esynr3z/kicad-lib/(commit log)

2018-08-26 Add NCP3163 with SOIC-16 footprint
2018-08-31 Add diode SMA fp
2018-09-19 Add some SMD capacitors
2018-09-19 Add MBRA340 diode
2018-09-19 Add BZX84C4V7 diode
2019-03-30 Add 1206 led fp
2019-04-02 Add pair of mosfet symbols
2019-04-05 Add some smd tact switches
2019-04-05 Add special pin header
2019-04-05 Add 3d model for 6x6 smd tact switch
2019-04-06 Fix fields in FET symbol lib
2019-10-13 Add pickle rick footprint
2019-10-13 Add m3 mounting hole footprint
2019-10-13 fix lm4871 footprint
2019-10-18 Add 3 pole solder jumper
2019-10-18 Add 2 pins connector symbol
2019-10-19 Add another solder jumper footprint
2019-10-19 Add tps54302 regulator
2019-10-21 Add several inductors footprints
2019-10-24 Update diode lib
2019-10-24 Add 0805 led
2019-10-27 Add mounting hole symbol
2019-10-27 Add screw terminal 5mm
2019-11-04 Add few pin headers
2019-11-04 Add 6 pin header
2019-11-04 Add connector symbols
2019-11-04 Add 5.2mm button switch
2019-11-05 Add 2x08 pin header
2019-11-07 Add customized screw terminal footprint
2019-11-07 Update custom screw terminal
